Raphael-Boichot/Arduino-MegaBurner-V2/Pictures/Chip_comparison.pptx

D7

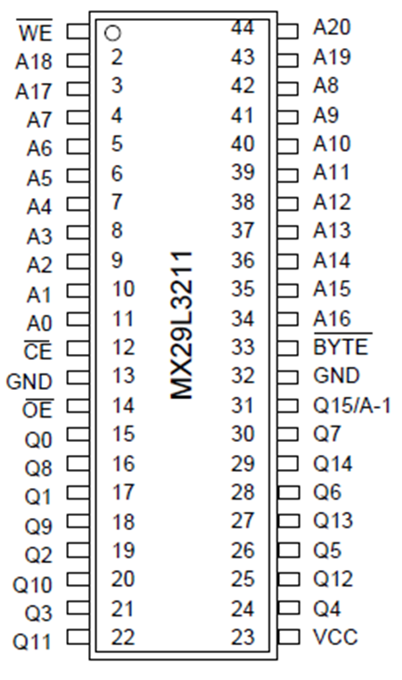
[picture p7: figure]

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
Mega2560 Pins

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
Mega2560 Pins

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
## Slide 2

TSOP 44 adapter

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
Arduino Mega 2560 Pins

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
## Slide 3

Digital (D) pins

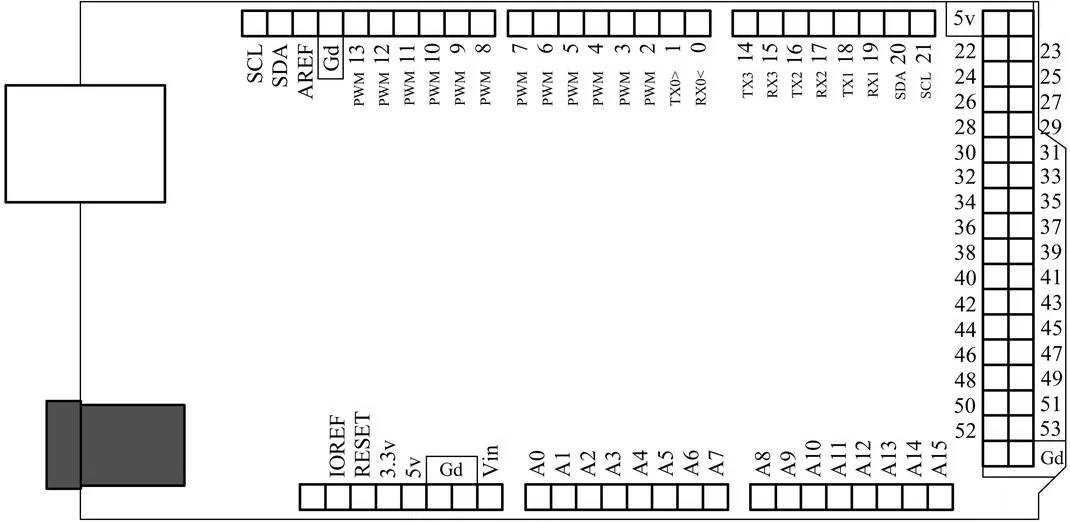
[picture p8: figure]
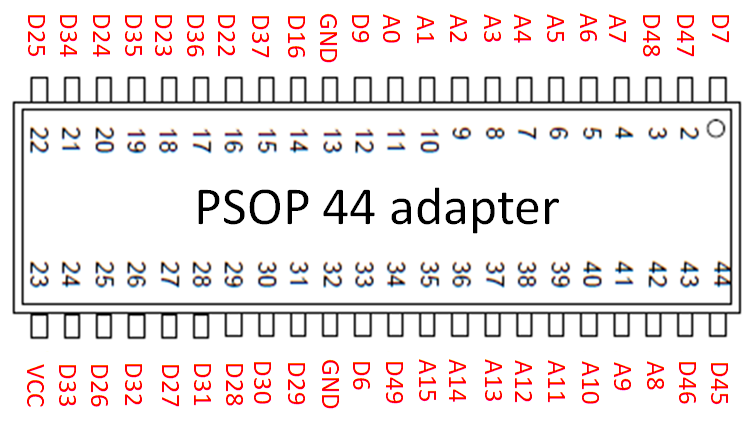
[picture p9: figure]

Green LED (Read)

Red LED (Write)

Digital (D) pins

VCC

Analog (A) pins

## Slide 4

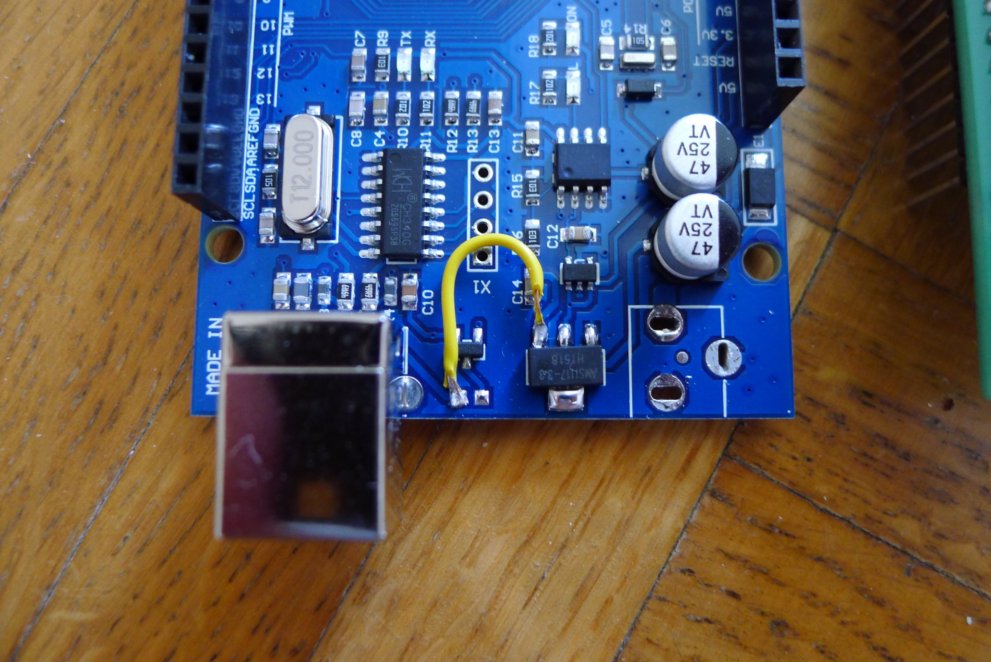
[picture p10: figure]

Remove the barrel jack

Replace by a AMS1117 3.3V

Remove the fuse

Connect USB +5V to the AMS1117 input
