Raphael-Boichot/Arduino-MegaBurner-V2/Pictures/SOP44_Pinout.png

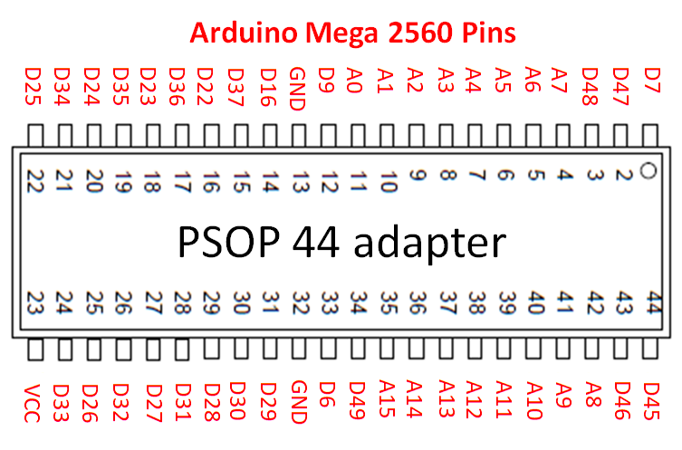
Pictures/SOP44_Pinout.png
