Raphael-Boichot/Arduino-MegaBurner-V2/(list of files, drawings)

Other design files:
PCB/PCB_MEGA_burner_2026-09-17.json
