Raphael-Boichot/Arduino-MegaBurner-V2/(commit log)

2026-09-13 Update README with wiring details and verification steps
    Added notes on wiring and verification process for Arduino setup.
2026-09-14 TimeOut on write error
    [FlashChip.h, MX26L6420.h, MX26L6420.ino, MX29L3211.h, MX29L3211.ino, MX29LV320E.h, MX29LV320E.ino, MegaBurner_arduino.ino]
2026-09-15 Fix wrong pin assignement for A21@MX26L6420
    [MX26L6420.h, MX26L6420.ino, chips.py]
2026-09-16 Update README with analog and digital pin clarification
    Clarified the distinction between analog and digital pins in the hardware section.
2026-09-17 chasing bugs in port com autodetect
    [driver.py]
2026-09-17 Fixes too short delay for Arduino to boot
    [driver.py]
